xuyizhou8129/axi-dma-engine/docs/tutorials.txt

Vivado: https://digilent.com/reference/programmable-logic/guides/getting-started-with-vivado
Microblaze: https://digilent.com/reference/programmable-logic/guides/getting-started-with-ipi
Vitis:
