xuyizhou8129/axi-dma-engine/(commit log)

2025-12-28 Creating the framework
2025-12-28 Testing Graph insertion
2026-03-26 axi4master completed and tested
    [example.csv]
2026-04-05 descriptor fetcher testbenched
    [test0.csv, test1.csv, test2.csv, test3.csv]
2026-04-10 sram_controller fixed and testbenched
    [bram.sv, sram_controller.sv]
2026-04-15 adding /sim files
    [example.csv]
2026-04-17 now descriptor format consistent in all models
    [example.csv]
2026-04-19 fixed sram current address
    [axi_4_master.sv, sram_controller.sv]
2026-04-19 added test case
    [max_inflight.csv, reverse_direction.csv]
2026-04-19 modifying comments for testcases files
    [max_inflight.csv, reverse_direction.csv]
2026-04-19 fixed sw model for reverse order handling, reverse_direction.csv passed
    [run_golden.py]
2026-04-19 Add scenario CSVs from pipeline_debug_Satviki
    Bring over near_sram_boundary_valid, ring_wrap_two_slots,
    single_sram_to_sys_len8, single_sys_to_sram_len8, and
    two_desc_chain_mixed_dir for shared regression coverage.
    Made-with: Cursor
    [near_sram_boundary_valid.csv, ring_wrap_two_slots.csv, single_sram_to_sys_len8.csv, single_sys_to_sram_len8.csv, two_desc_chain_mixed_dir.csv]
2026-04-19 added more testcases and debugging
    [example.csv, max_inflight.csv, near_sram_boundary_valid.csv, reverse_direction.csv, ring_wrap_two_slots.csv, single_sram_to_sys_len8.csv, single_sys_to_sram_len8.csv, two_desc_chain_mixed_dir.csv]
2026-04-19 fixed near boundary check
    [near_sram_boundary_valid.csv]
2026-04-20 ring_wrap_two_slots test fixed
    [ring_wrap_two_slots.csv]
2026-04-24 hello-world for microblaze ready
    [cmake_lib_configs.txt]
2026-05-01 Sync rtl/ from pipeline_debug_Mike
    - dma_top.sv: use dma_pkg::MAX_INFLIGHT default, add .soc modport on soc_bus
    - movement_top.sv: fix typo (Memmory → Memory)
    - rm_irq_top.sv: add new synthesis wrapper for ring_manager + IRQ
    - system_top.sv: add new sim/synth top bundling dma_top + sys_mem
    - vivado_config.sv: remove (superseded by above wrappers)
    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
    [movement_top.sv, vivado_config.sv]
2026-05-01 let leave resolve which side of the port it is
    [vivado_config.sv]
2026-05-02 created custom DMA IP
    [cmake_lib_configs.txt]
2026-05-06 trying to debug uart_read_write.c
2026-05-07 firmware fixed, using Xil_In
    [uart_read_write.c]
2026-05-08 adding debugging printfs
2026-05-08 Refactor UART read/write functions for consistency
2026-05-08 timing out issue, local fixing
    [serial_host.py]
2026-05-09 uart changes
2026-05-09 firmware, uart restore baseaddr, ringlen, tail
2026-05-12 cleaning up main
    [cmake_lib_configs.txt, example.csv, test0.csv, test1.csv, test2.csv, test3.csv]
